michaelkamprath/rgb-led-matrix/(list of files, drawings)

Other design files:
hardware/4x4-rgd-led-matrix.fzz
hardware/10x10-rgd-led-matrix.fzz
hardware/teensy3.6-5v-logic.fzz
