michaelkamprath/rgb-led-matrix/drivers/arduino/rgd-led-matrix-lib/RGBImage.cpp

#include <string.h>
#include "RGBImage.h"

RGBImage::RGBImage(int rows, int columns)
:	_rows(rows),
	_columns(columns),
	_data(new ColorType[rows*columns])
{
	this->paintColor(BLACK_COLOR);
}

void RGBImage::copy(const RGBImage& other) {
	// only copy if same dimensions
	if (other._rows == _rows && other._columns == _columns) {
		memcpy(_data, other._data, _rows*_columns);
	}
}

ColorType& RGBImage::pixel( int row, int column ) { 
	return _data[row*_columns + column];
}
const ColorType& RGBImage::pixel( int row, int column ) const {
	return _data[row*_columns + column];
}


void RGBImage::placeImageAt( const RGBImage& image, int row, int column ) {
	if (	row >= _rows
			|| column >= _columns
			|| (image._columns + column <= 0 )
			|| (image._rows + row <= 0) 
		) {
		return;
	}

	int imageX = 0;
	int thisX = column;
	if (column < 0) {
		imageX = -column;
		thisX = 0;
	}
	
	int imageColumns = image._columns - imageX;
	int thisColumns = column <= 0 ? this->_columns : this->_columns - column;
	if (imageColumns > thisColumns) {
		imageColumns = thisColumns;
	}

	int imageY = 0;
	int startRow = row;
	if (row < 0) {
		imageY = -row;
		startRow = 0;
	}

	for ( int yT = startRow, yO = imageY; yT < this->_rows && yO < image._rows; yT++, yO++ ) {     
		memcpy(&this->pixel(yT,thisX),&image.pixel(yO,imageX), imageColumns);
	}
}

void RGBImage::paintColor( ColorType color ) {
	memset(_data,color,_rows*_columns);
}
