michaelkamprath/rgb-led-matrix/(commit log)

2017-02-11 first working version
    The driver in the commit is not final yet as it isn't aligned for the
    bit layout of the 8x8 hardware design. Will update when 8x8 matrix is
    finalized
2017-02-11 added license and renamed Arduino lib
2017-02-11 corrected bit order for hardware design
    [Screen.cpp]
2017-02-18 Corrected line drawing algorithm
    [RGBImage.cpp]
2017-02-19 Added schottky diode to improve switching speed
    To improve the row transistors switching speed, schottky diodes were added.
    Also compressed the LED lay out making room for mounting holes.
2017-02-25 added resistors to drain parasitic capacitance from LEDs
2017-02-25 added design for 4x4 RGB LED matrix
    [4x4-rgd-led-matrix.fzz]
2017-02-26 finalized revised pcb layout
2017-04-08 added arduino default pin connections
2017-05-29 Updated Arduino driver to user SPI
    Updated the arduino drive to use SPI to speed up bit shifting.
    Also improved the LED matric bit writing loop speed incrementally.
2017-05-29 switch LATCH to SPI SS pin
2017-05-31 added mechanism to track need for image updates
2017-05-31 removed duplicative latch pin management
    Missed removing the legacy latch pin management in the move the SPI.
2017-06-11 implemented bit cache
    Implemented a bit cache for the bits that get transmited to the matrix device.
    The bit cache retains all bits for each row and provides convenience functions
    for controlling columns and row state.
2017-06-11 implemented use of timer interupt for PWM
    Refactors code to use a timer interup to driver the updates to the
    shift registers. This creates a much more stable update cycle, removing
    all flickering caused by compute load. Code currently only supports
    running a single LED matrix. A future upgrade will make code compatible
    with multiple matrices.
    Note that this code now uses TIMER2 to drive the PWM. As a result, the
    services that user TIMER2 are no longer available, specifically tone().
2017-06-11 refactored to use binary code modulation
    Prior to this, the multiple scan passes for each frame effectively implement BCM for creating
    shades of gray. By changing the interval of the timer, we can get the same effect and use
    less CPU to do it. This leaves more cycles for animation computations.
2017-06-11 fixed a bug
    Fixed a big that prevent all 3 bit frames from being used. Also made some minor tweaks.
2017-07-21 add 10x10 matrix hardware design
    [10x10-rgd-led-matrix.fzz]
2017-08-05 added 10x10 matrix support
    Original code was mostly there for a 10x10 matrix. Did a few tweaks to
    the update timing, and fixed the animation code to better handle
    glyph and image animations that don't fill entire matrix.
    [RGBImage.cpp]
2017-08-13 removed flicker from scrolling animations
    Removed the flickerthat occured during scrolling animations when the
    animated image or glyph was not the same size as the LED matrix.
    Also made the start/stop drawing calls on the matrix object stackable.
    Each startDrawing() must be balanced with a stopDrawing() call to enable
    screen updates for the changes.
2017-08-26 improved update cycle timing
    The last row of the matrix ended up being marginally brighter than the others.
    The root cause was the scan row management that occured after the last row update.
    On the last row, that management code took a longer code path to reset various
    counter. This of course took longer and as a result the last row was on for a marginally
    longer period of time than the other rows. This timing difference was perceptible in
    the red color on the matrix with the red in the last row being a little bit brighter
    than the other rows.
    Solution was to move the scan row management code to outside of the code path
    where the update timer is turned off. By doing so, the work done when t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
2017-09-02 added support for Teensy 3.x microcontroller boards
    [teensy3.6-5v-logic.fzz]
2017-09-02 updated driver library to be standard format
    Update the Arduino driver to be a standard library format so that that it can
    be published by the Arduino Library Manager.
    Also address some compilation warnings
2017-09-02 improved PWM timing on Teensy boards
2017-09-07 added full support for 24 bit color
    Added support for 24 bit color. You can switch between 24 bit and 6 bit color using the
    preprocessor flag TWENTY_FOUR_BIT_COLOR. However, it should be noted that 24 bit color
    will not work on 2K RAM arduinos. You'll need something with much more RAM, like a
    Teensy 3.x.
    [RGBImage.cpp, RGBImage.h]
2017-09-17 general code improvements
    - Updated README
    - Adjusted 6-bit ORANGE_COLOR to eb more orange
    - Refactored object constructiion to delay heavy lifting to the setup() function
    - Added support for Arduino Mega 2560
    - Prevent code from compiling for Arduino Due and Zero while I figure out how to support those boards.
    [RGBImage.h]
2017-09-17 extended 24-bit color support to the Arduino Mega 2560
2017-10-29 Single color led matrix (#6)
    * improved functionality of Glyph
    * update examples to call setup on matrix
    * enabled mono-color LED matrix support
    * corrected license notice
    * fixed compilation warnings
    * fixed compilation warnings
    * made setup method virtual
    * improved compatibility with ESP8266
    * code cleanup
2017-11-11 more ESP8266 boards
2017-11-11 preparing arduino driver to stand alone
2017-11-12 migrating arduino code to its own repository
